rgronberg/mains-monitor/3d-models/IC DIP 16-pin.step

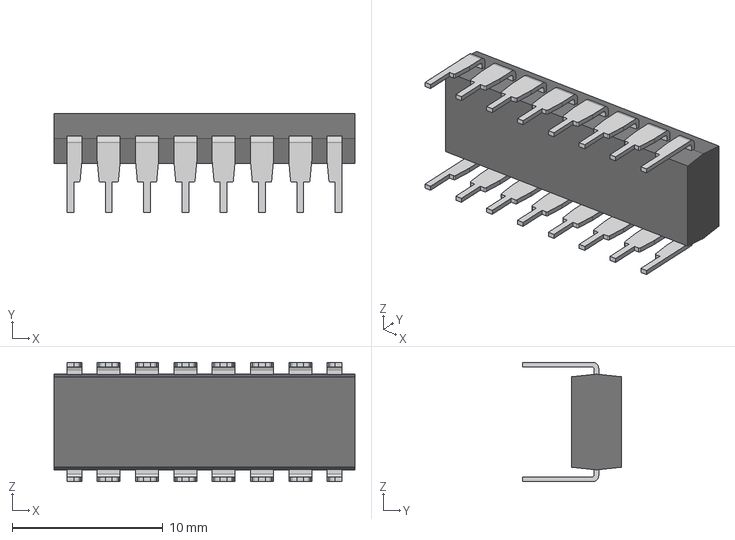
[picture p1: CAD file, 2024-11-23]
3d-models/IC DIP 16-pin.step
20.0 x 6.55 x 7.92 mm
