rgronberg/mains-monitor/3d-models/Hi-Link HiLink HLK-PM.STEP

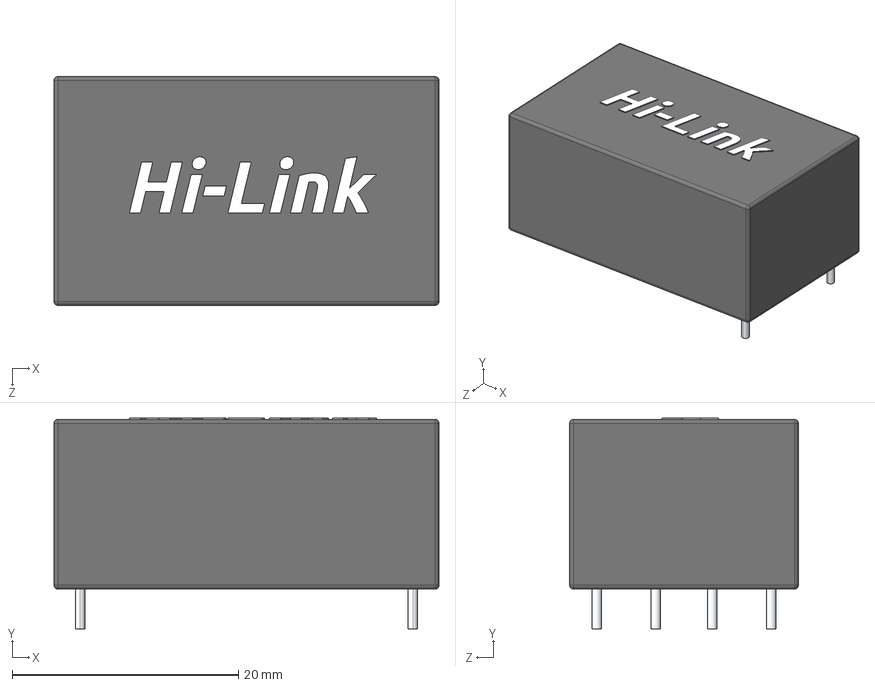
[picture p2: CAD file, 2024-11-23]
3d-models/Hi-Link HiLink HLK-PM.STEP
34.0 x 18.6 x 20.2 mm
