rgronberg/mains-monitor/3d-models/PJ320A.STEP

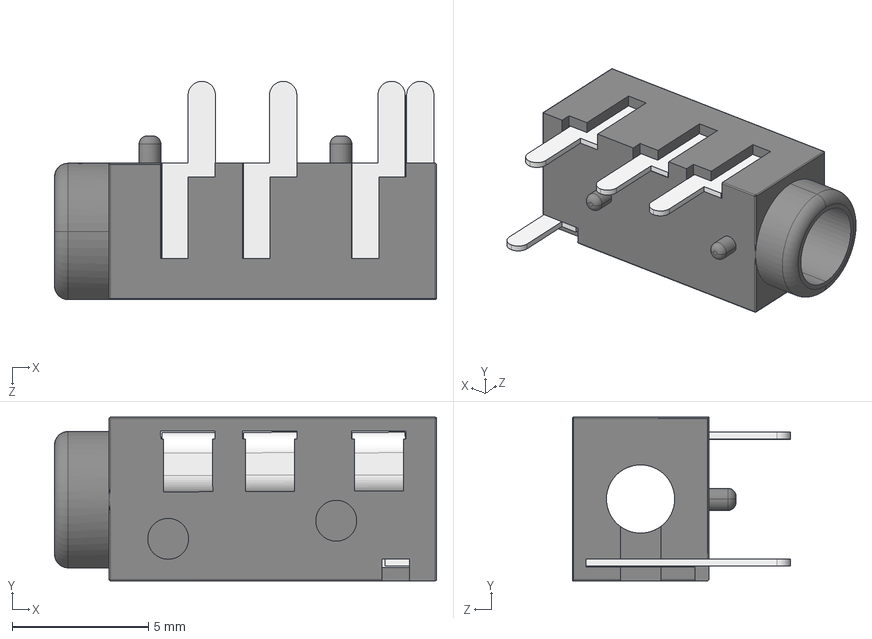
[picture p3: CAD file, 2024-11-23]
3d-models/PJ320A.STEP
14.0 x 6.00 x 8.00 mm
PJ320A
PJ320A-Pin x 3
PJ320A-Pin-B
