rgronberg/mains-monitor/3d-models/2 PIN - DG306-5 - PITCH 5 mm.stp

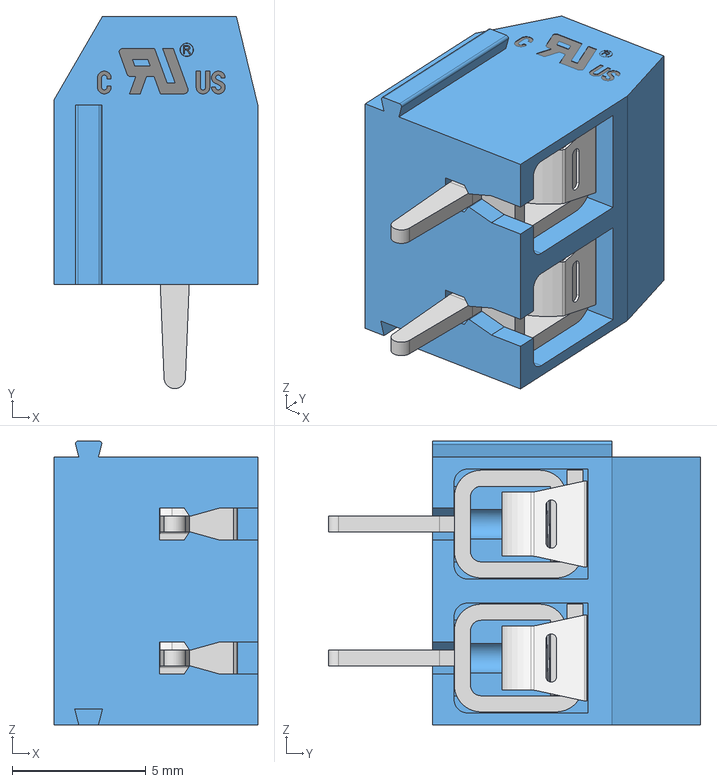
[picture p4: CAD file, 2024-11-23]
3d-models/2 PIN - DG306-5 - PITCH 5 mm.stp
7.60 x 13.9 x 10.6 mm
