rgronberg/mains-monitor/3d-models/1825910-6.step

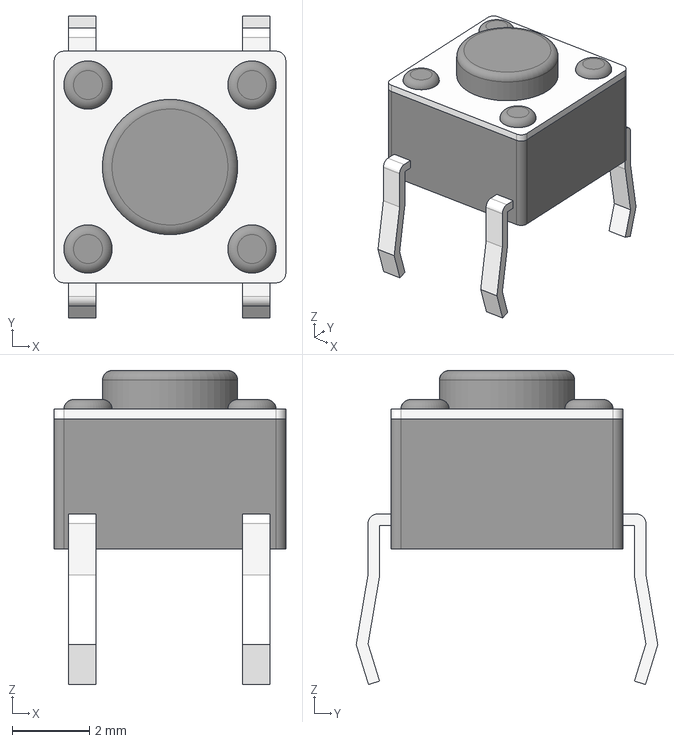
[picture p5: CAD file, 2024-11-23]
3d-models/1825910-6.step
5.99 x 7.80 x 8.12 mm
