rgronberg/mains-monitor/mains-monitor.kicad_pcb

## KiCad design mains-monitor.kicad_pcb (2024-11-23)

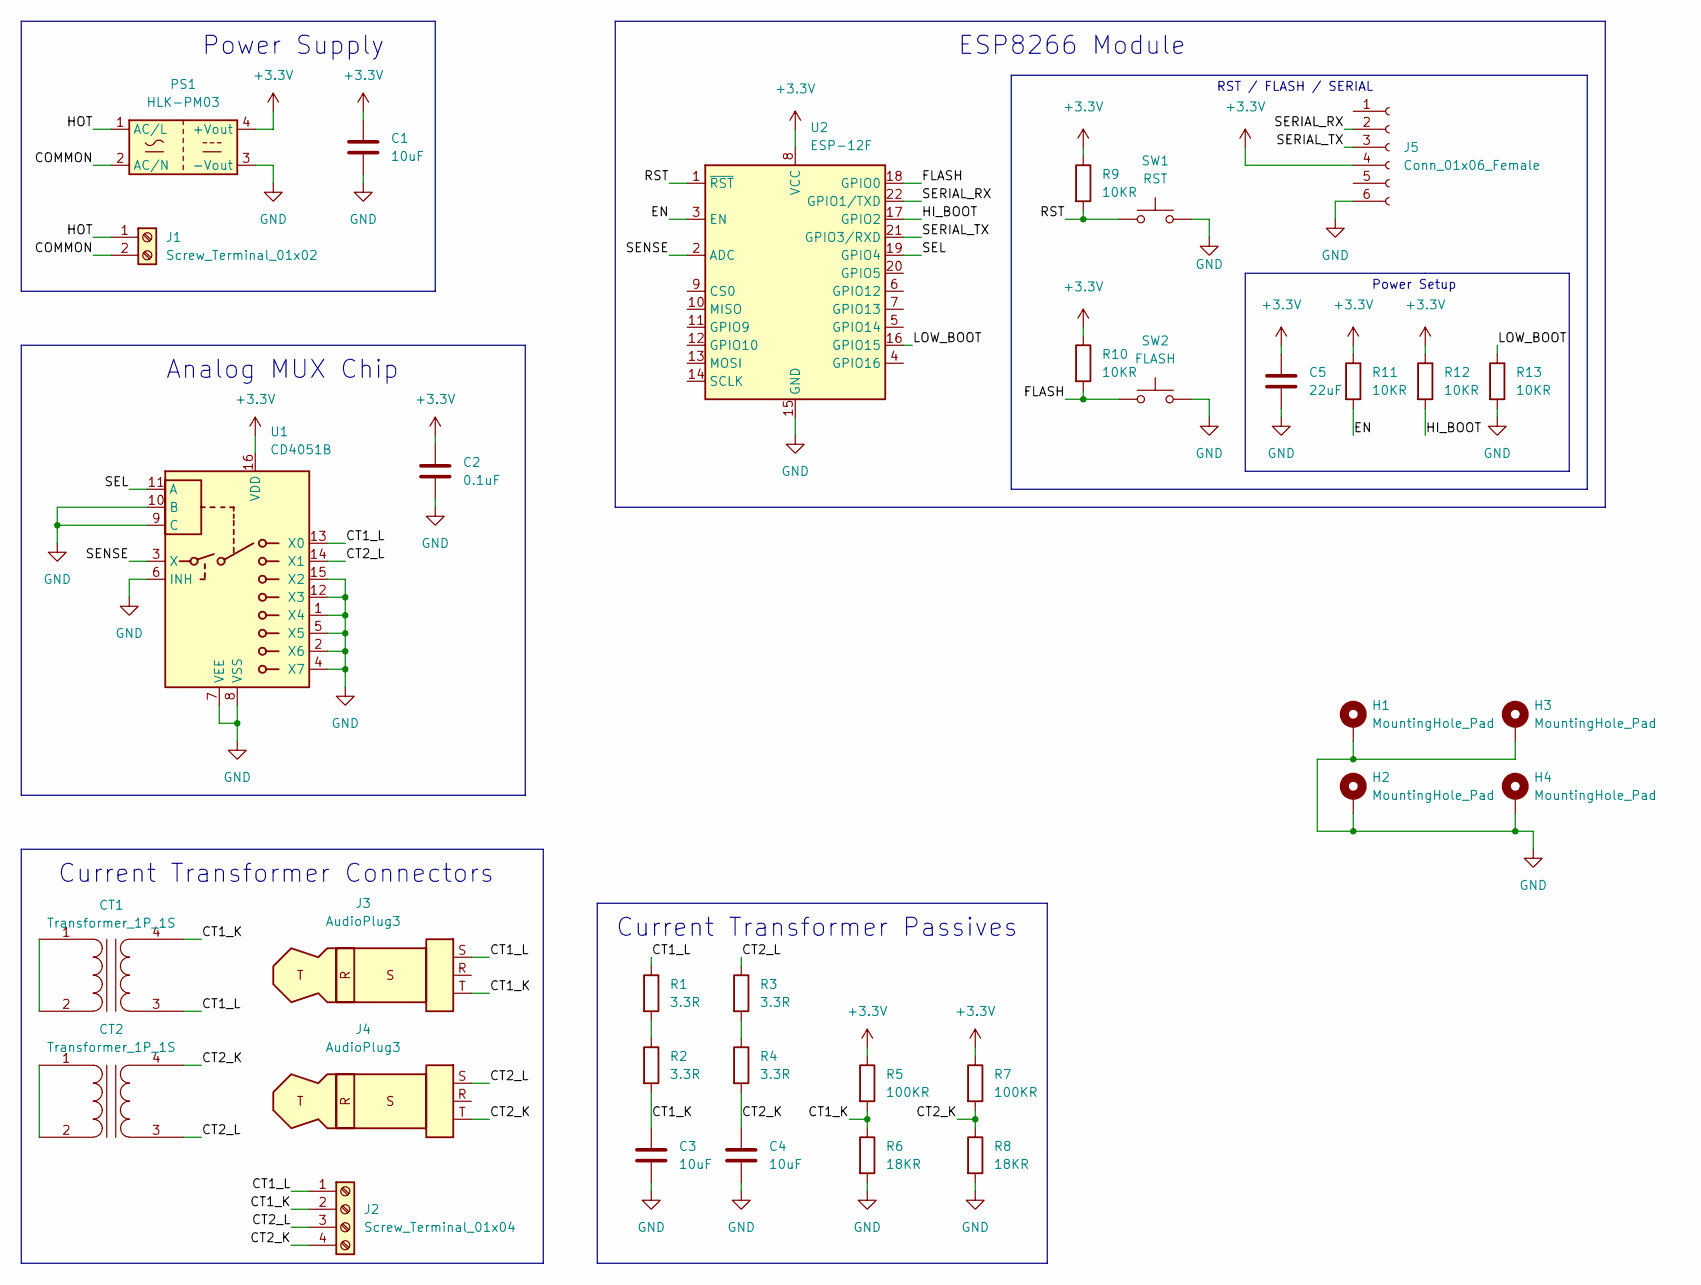
[picture p6: schematic mains-monitor.kicad_sch, Current Monitor]

Parts:
C1: 10uF; C_1206_3216Metric
C2: 0.1uF; C_1206_3216Metric
C3, C4: 10uF; C_0805_2012Metric
C5: 22uF; C_1206_3216Metric
CT1, CT2: Transformer_1P_1S
H1, H2, H3, H4: MountingHole_Pad; MountingHole_3.2mm_M3_Pad_Via
J1: Screw_Terminal_01x02; TerminalBlock_bornier-2_P5.08mm
J2: Screw_Terminal_01x04; TerminalBlock_Altech_AK300-4_P5.00mm
J3, J4: AudioPlug3; Jack_3.5mm_PJ320A_Horizontal
J5: Conn_01x06_Female; PinSocket_1x06_P2.54mm_Vertical
PS1: HLK-PM03; Converter_ACDC_HiLink_HLK-PMxx
R1, R2, R3, R4: 3.3R; R_0805_2012Metric
R5, R7: 100KR; R_0805_2012Metric
R6, R8: 18KR; R_0805_2012Metric
R9, R10, R11, R12, R13: 10KR; R_Axial_DIN0207_L6.3mm_D2.5mm_P7.62mm_Horizontal
SW1: RST; SW_PUSH_6mm
SW2: FLASH; SW_PUSH_6mm
U1: CD4051B; DIP-16_W7.62mm
U2: ESP-12F; ESP-12E

Connections:
+3.3V: C1.1, C2.1, C5.2, J5.4, PS1.4 (+Vout), R5.1, R7.1, R9.1, R10.1, R11.1, R12.1, U1.16 (VDD), U2.8 (VCC)
/COMMON: J1.2, PS1.2 (AC/N)
/CT1_K: C3.1, CT1.4 (SB), J2.2, J3.T, R2.2, R5.2, R6.1
/CT1_L: CT1.3 (SA), J2.1, J3.S, R1.1, U1.13 (X0)
/CT2_K: C4.1, CT2.4 (SB), J2.4, J4.T, R4.2, R7.2, R8.1
/CT2_L: CT2.3 (SA), J2.3, J4.S, R3.1, U1.14 (X1)
/EN: R11.2, U2.3 (EN)
/FLASH: R10.2, SW2.1, U2.18 (GPIO0)
/HI_BOOT: R12.2, U2.17 (GPIO2)
/HOT: J1.1, PS1.1 (AC/L)
/LOW_BOOT: R13.1, U2.16 (GPIO15)
/RST: R9.2, SW1.1, U2.1 (~RST)
/SEL: U1.11 (A), U2.19 (GPIO4)
/SENSE: U1.3 (X), U2.2 (ADC)
/SERIAL_RX: J5.2, U2.22 (GPIO1/TXD)
/SERIAL_TX: J5.3, U2.21 (GPIO3/RXD)
unnamed: CT1.1 (AA), CT1.2 (AB)
unnamed: CT2.1 (AA), CT2.2 (AB)
unnamed: R1.2, R2.1
unnamed: R3.2, R4.1

Notes on the sheet:
Power Supply
Current Transformer Connectors
Analog MUX Chip
Power Setup
RST / FLASH / SERIAL
Current Transformer Passives
ESP8266 Module

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
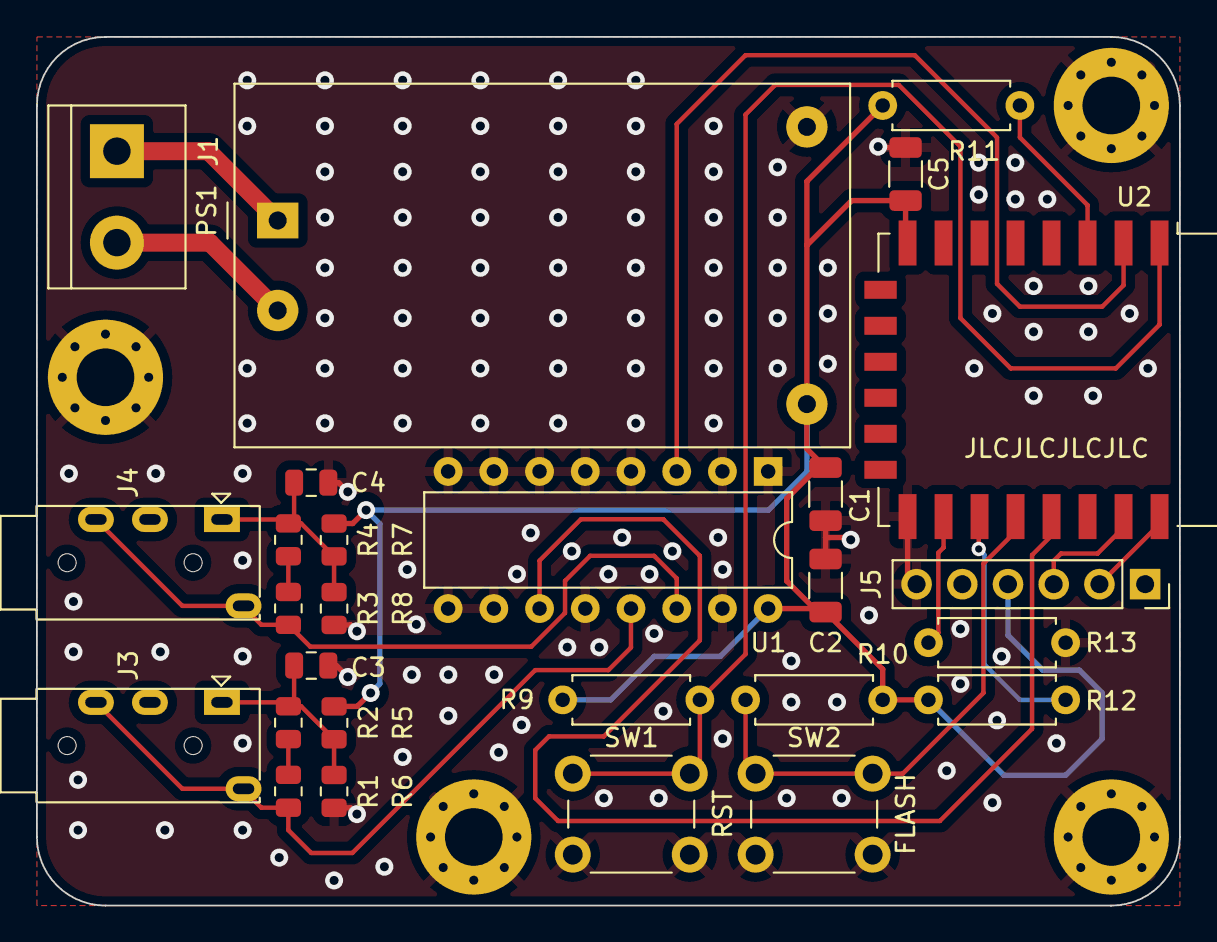
[picture p7: board mains-monitor.kicad_pcb from above]

Board: 2 copper layers, 63.5 x 48.3 mm, 31 parts (0 on the bottom side), 19 nets.
