rgronberg/mains-monitor/(commit log)

2023-03-31 Update MainsMonitor to use config calibration and voltage
2023-03-31 Reduce number of samples in MainsMonitor
2023-03-31 Use flash button long hold to reset settings
    [MainsMonitor.cpp, MainsMonitor.hpp, WebServer.cpp]
2023-03-31 Reboot device if hostname is changed
    [WebServer.cpp, WebServer.hpp]
2023-03-31 Change default current calibration
2023-04-22 Change monthly reset date to the first
    [MainsMonitor.cpp]
2024-11-23 Add PCB to repo
    [1825910-6.step, 2 PIN - DG306-5 - PITCH 5 mm.stp, Hi-Link HiLink HLK-PM.STEP, IC DIP 16-pin.step, PJ320A.STEP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]
2025-04-23 KiCad changes
2025-04-23 Add configurable reset date
    [EmonConfig.cpp, EmonConfig.hpp, MainsMonitor.cpp, WebServer.cpp, mains-monitor.cpp]
