rgronberg/mains-monitor/(notices)

Notices in the files:
mains-monitor.kicad_sch:
Licence: WTFPL
